robotronik/cdfr2019-1A/electronique/carte_principale_robot1A_cdF_2019/attribution_pattes_nucleo.pdf

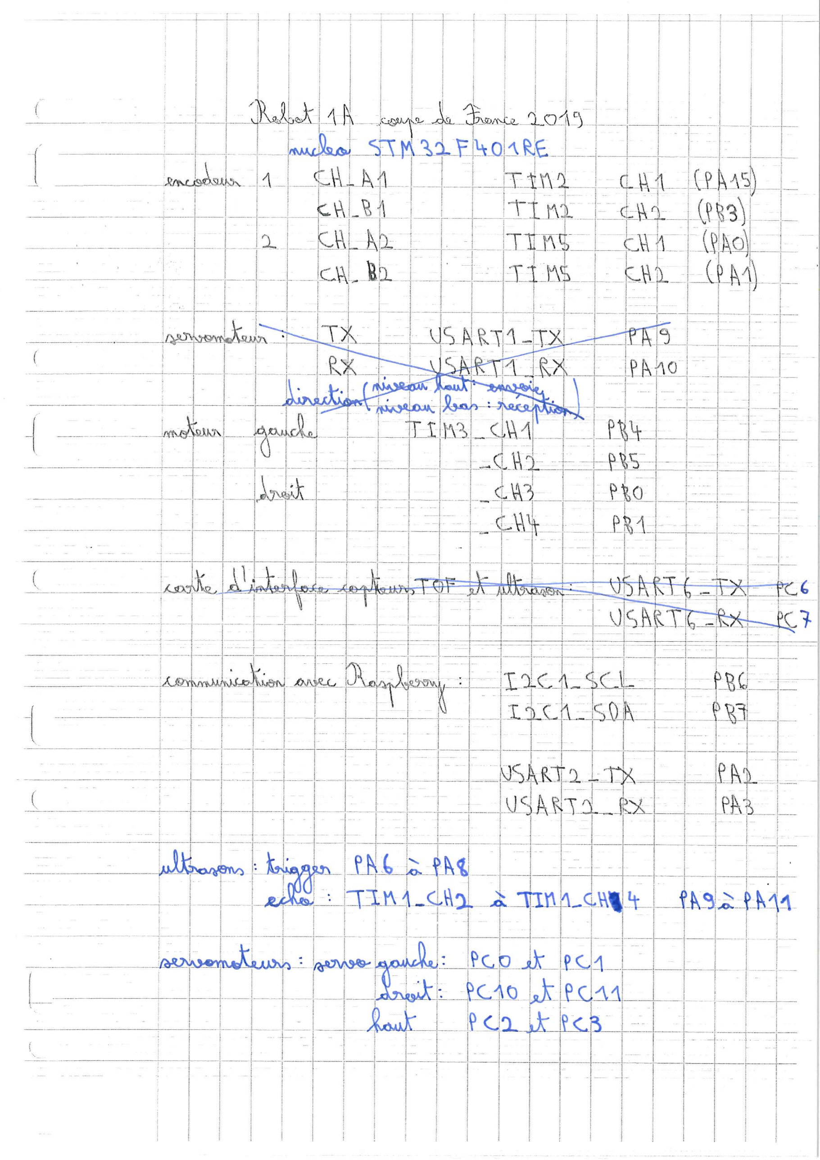
[picture p1: page 1]
