robotronik/cdfr2019-1A/electronique/carte_principale_robot1A_cdF_2019/carte_principale_robot1A_cdF2019.pdf

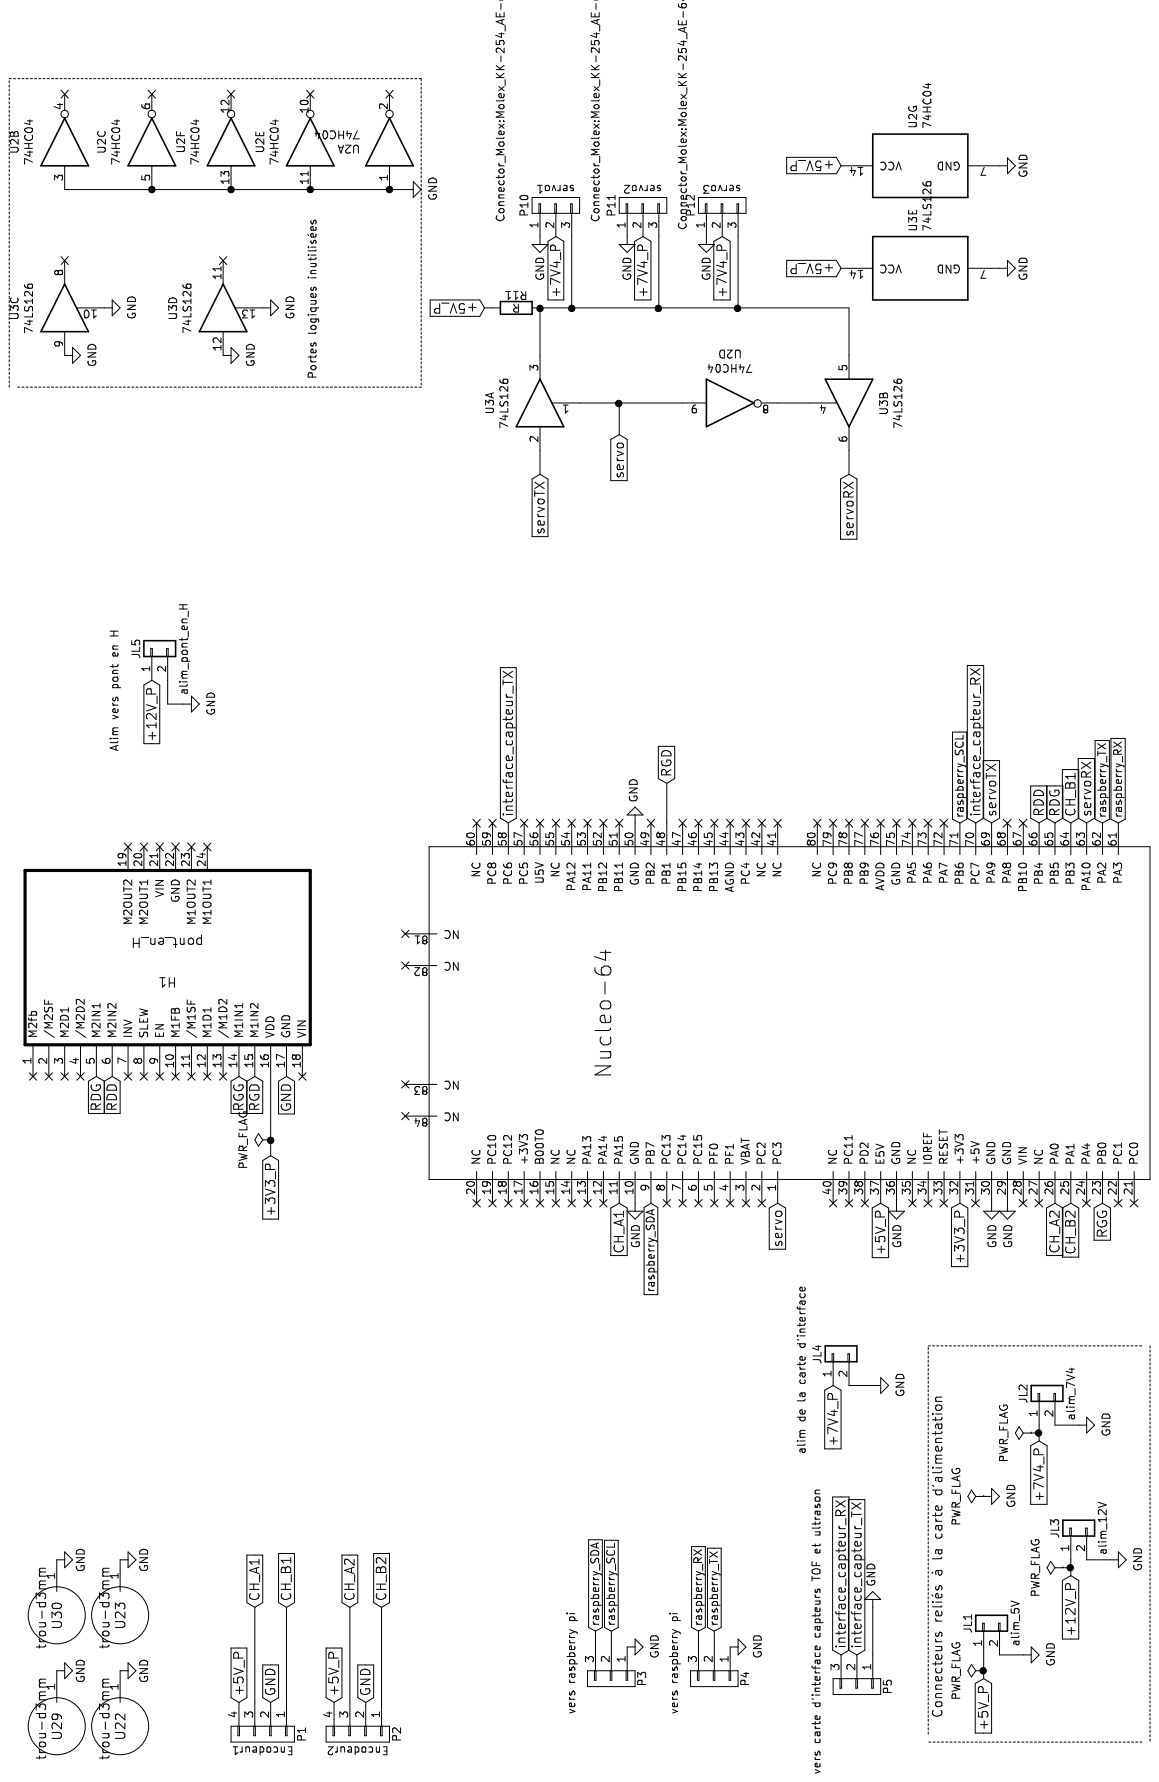
[picture p2: page 1]
