robotronik/cdfr2019-1A/electronique/carte_principale_robot1A_cdF_2019/carte_principale_robot1A_cdF2019.kicad_pcb

## KiCad design electronique/carte_principale_robot1A_cdF_2019/carte_principale_robot1A_cdF2019.kicad_pcb (2019-03-20)

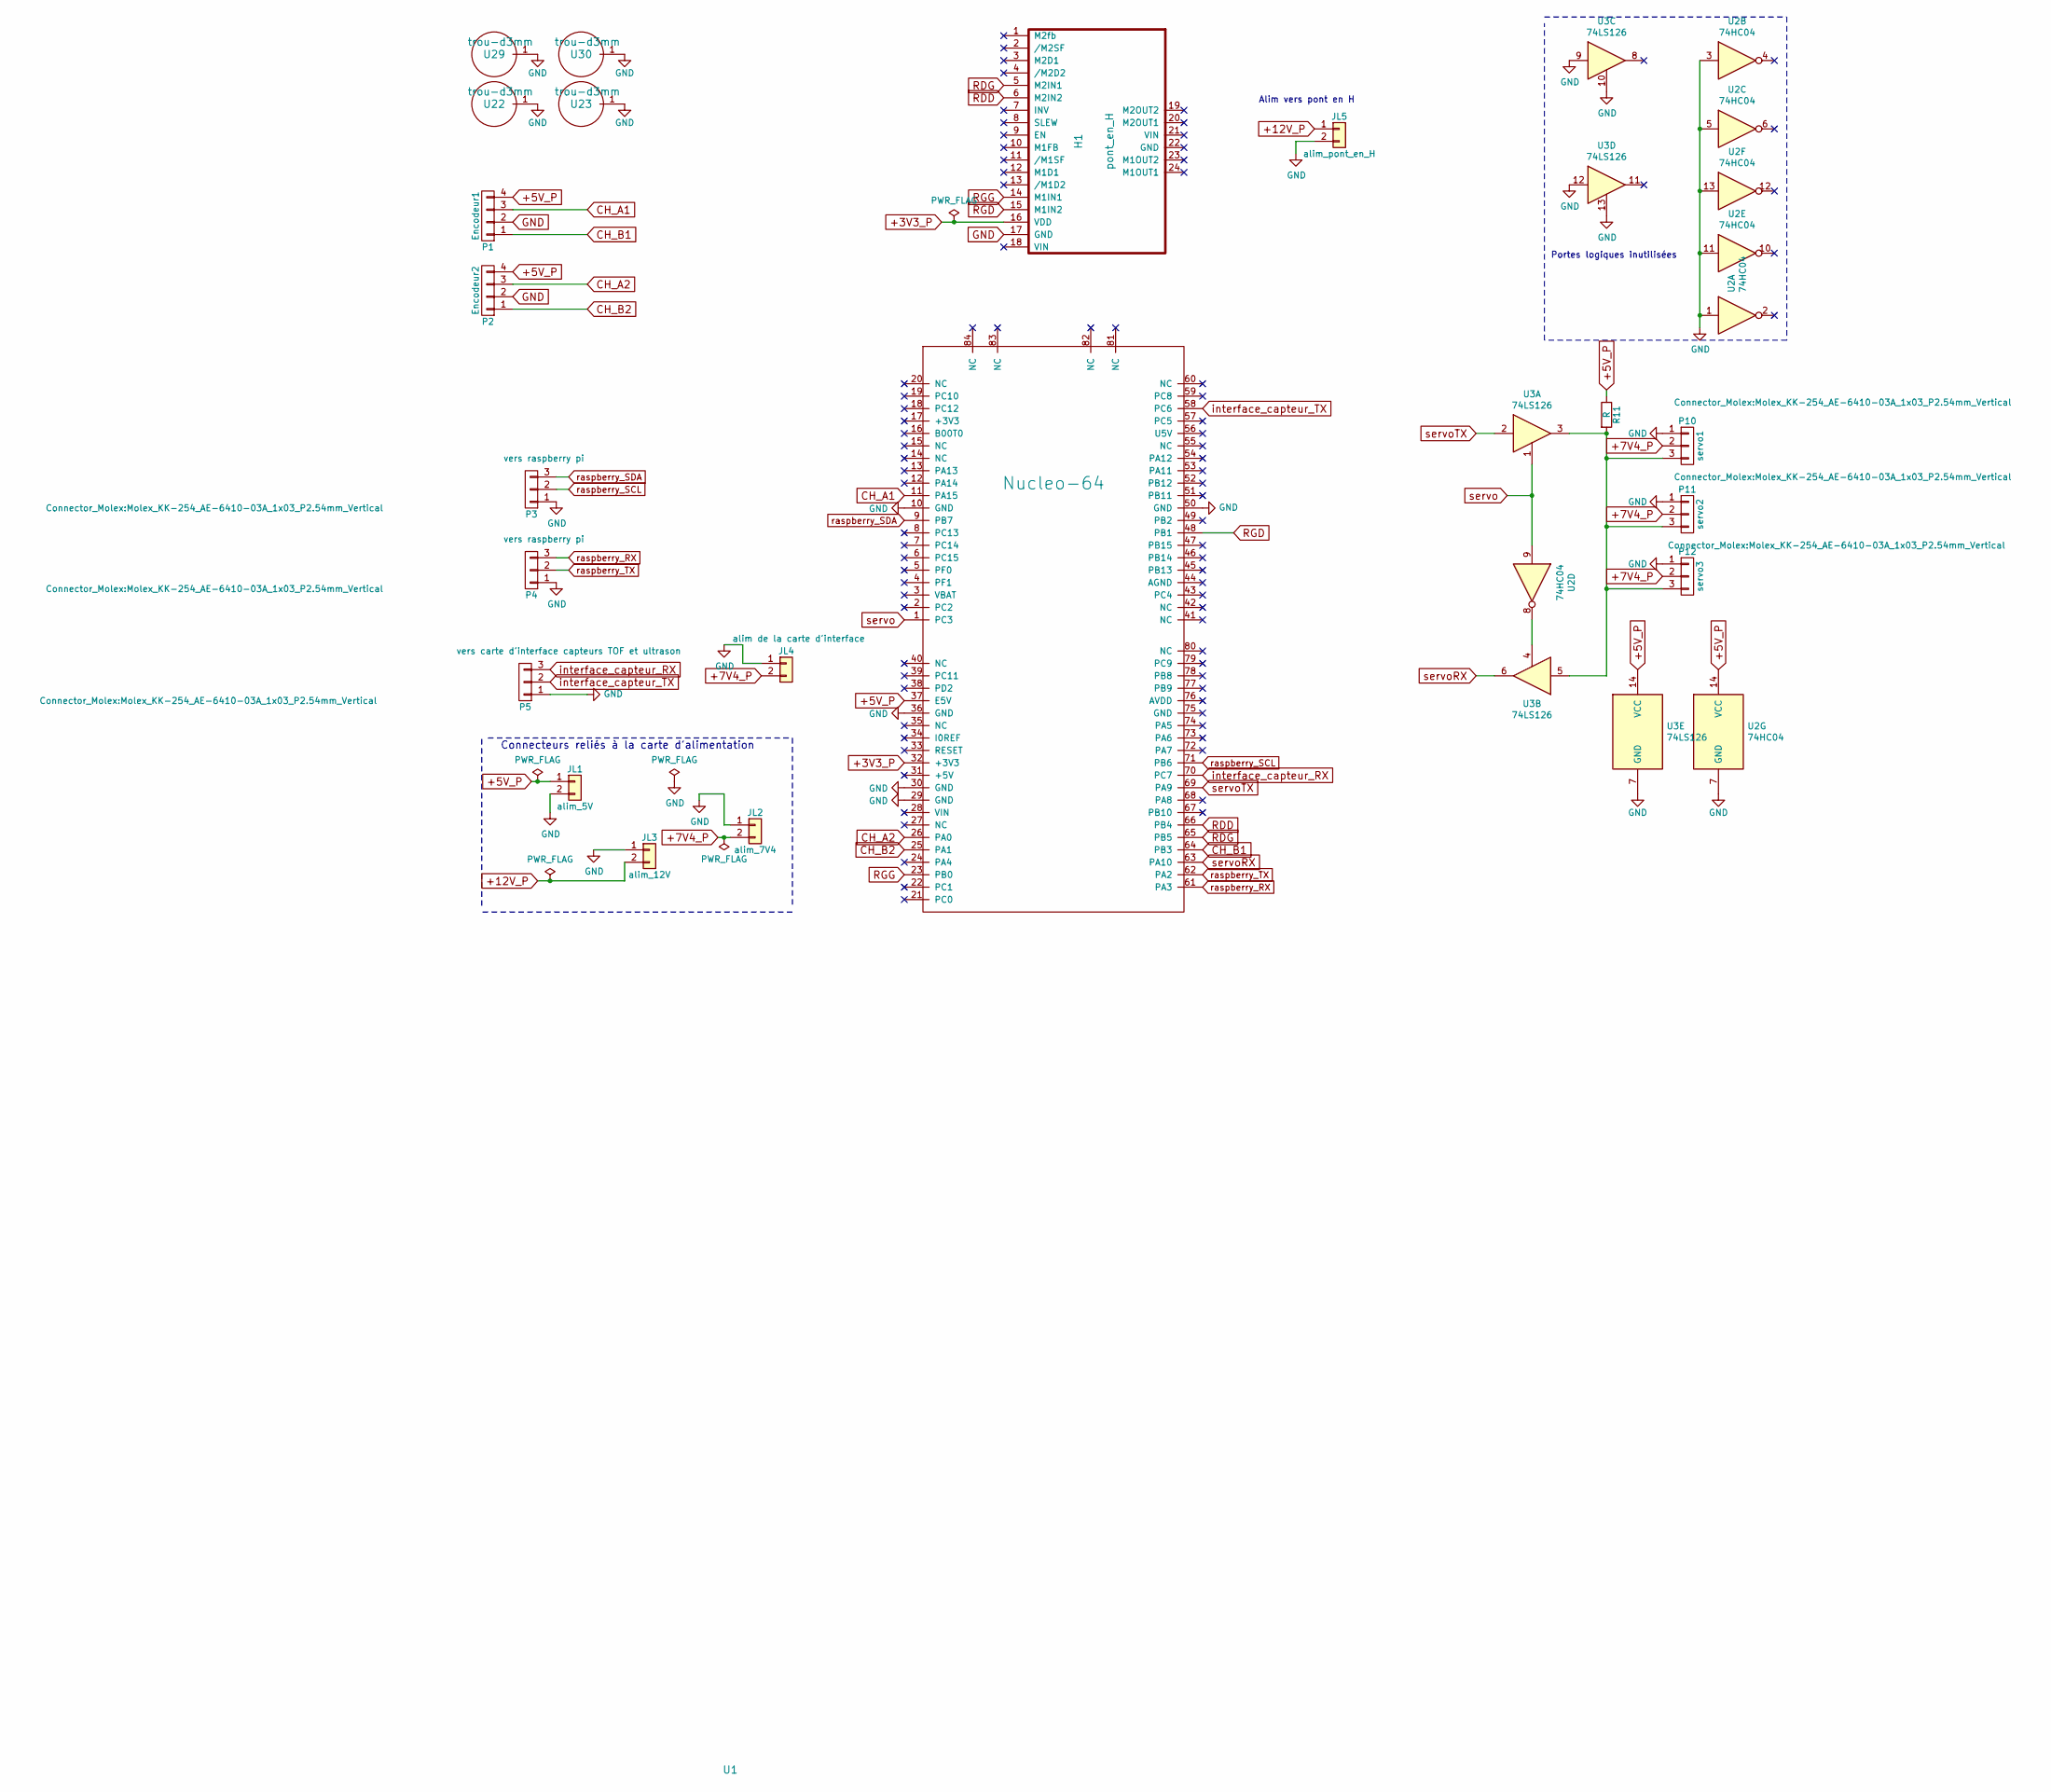
[picture p3: schematic carte_principale_robot1A_cdF2019.sch]

Parts:
H1: pont_en_H; MC33926-Pont en H
JL1: alim_5V; Molex_KK-254_AE-6410-02A_1x02_P2.54mm_Vertical
JL2: alim_7V4; B plug 5mm
JL3: alim_12V; B plug 5mm
JL4: alim de la carte d'interface; B plug 5mm
JL5: alim_pont_en_H; PinHeader_1x02_P2.54mm_Vertical
P1: Encodeur1; Molex_KK-254_AE-6410-04A_1x04_P2.54mm_Vertical
P2: Encodeur2; Molex_KK-254_AE-6410-04A_1x04_P2.54mm_Vertical
P3, P4: vers raspberry pi; Molex_KK-254_AE-6410-03A_1x03_P2.54mm_Vertical
P5: vers carte d'interface capteurs TOF et ultrason; Molex_KK-254_AE-6410-03A_1x03_P2.54mm_Vertical
P10: servo1; Molex_KK-254_AE-6410-03A_1x03_P2.54mm_Vertical
P11: servo2; Molex_KK-254_AE-6410-03A_1x03_P2.54mm_Vertical
P12: servo3; Molex_KK-254_AE-6410-03A_1x03_P2.54mm_Vertical
R11: R; R_1206_3216Metric
U1: Nucleo-64
U2: 74HC04; DIP-14_W7.62mm
U3: 74LS126; DIP-14_W7.62mm
U22, U23, U29, U30: trou-d3mm; trou_d3mm

Connections:
+3V3_P: H1.16 (VDD), U1.32 (+3V3)
+5V_P: JL1.1, P1.4, P2.4, R11.1, U1.37 (E5V), U2.14 (VCC), U3.14 (VCC)
+7V4_P: JL2.2, JL4.2, P10.2, P11.2, P12.2
+12V_P: JL3.2, JL5.1
CH_A1: P1.3, U1.11 (PA15)
CH_A2: P2.3, U1.26 (PA0)
CH_B1: P1.1, U1.64 (PB3)
CH_B2: P2.1, U1.25 (PA1)
GND: H1.17 (GND), JL1.2, JL2.1, JL3.1, JL4.1, JL5.2, P1.2, P2.2, P3.1, P4.1, P5.1, P10.1, P11.1, P12.1, U1.10 (GND), U1.29 (GND), U1.30 (GND), U1.36 (GND), U1.50 (GND), U2.1, U2.3, U2.5, U2.7 (GND), U2.11, U2.13, U3.7 (GND), U3.9, U3.10, U3.12, U3.13, U22.1, U23.1, U29.1, U30.1
unnamed: P10.3, P11.3, P12.3, R11.2, U3.3, U3.5
unnamed: U2.8, U3.4
RDD: H1.6 (M2IN2), U1.66 (PB4)
RDG: H1.5 (M2IN1), U1.65 (PB5)
RGD: H1.15 (M1IN2), U1.48 (PB1)
RGG: H1.14 (M1IN1), U1.23 (PB0)
interface_capteur_RX: P5.3, U1.70 (PC7)
interface_capteur_TX: P5.2, U1.58 (PC6)
raspberry_RX: P4.3, U1.61 (PA3)
raspberry_SCL: P3.2, U1.71 (PB6)
raspberry_SDA: P3.3, U1.9 (PB7)
raspberry_TX: P4.2, U1.62 (PA2)
servo: U1.1 (PC3), U2.9, U3.1
servoRX: U1.63 (PA10), U3.6
servoTX: U1.69 (PA9), U3.2

Notes on the sheet:
Connecteurs reliés à la carte d'alimentation
Alim vers pont en H
Portes logiques inutilisées

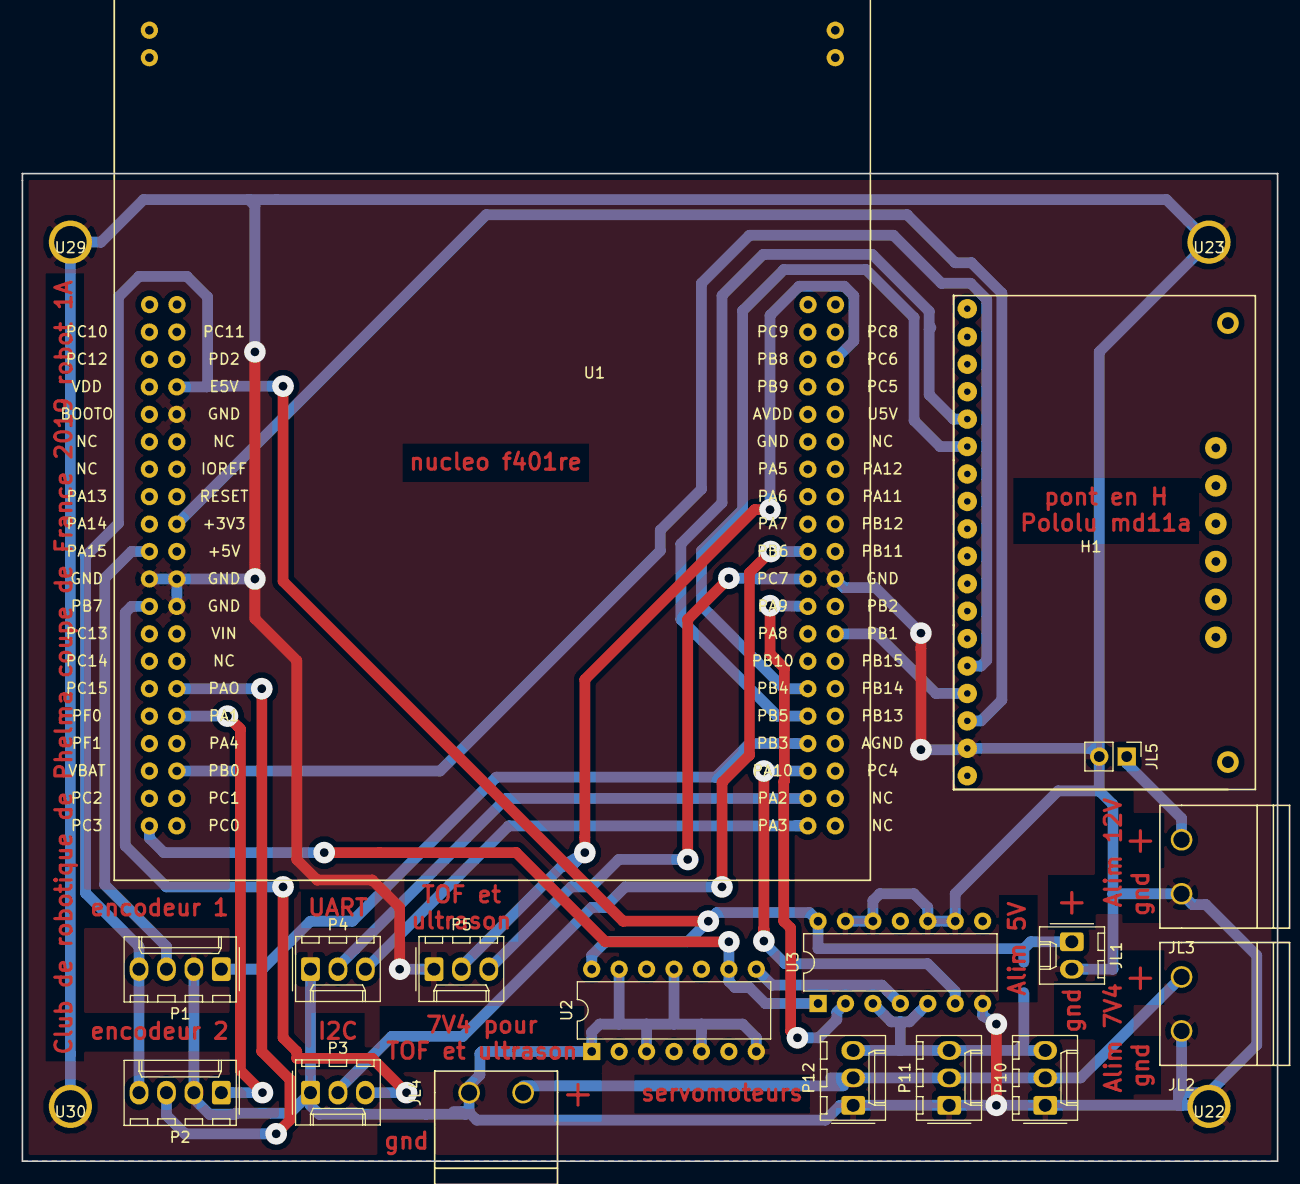
[picture p4: board carte_principale_robot1A_cdF2019.kicad_pcb from above]

Board: 2 copper layers, 116.2 x 91.4 mm, 22 parts (1 on the bottom side), 24 nets.
