robotronik/cdfr2019-1A/asservissement/Src/main.c

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

/* Includes ------------------------------------------------------------------*/
#include "main.h"
#include "tim.h"
#include "usart.h"
#include "gpio.h"
#include "encoder.h"
/* USER CODE BEGIN Includes */
#include "stm32f4xx_hal.h"

/* USER CODE END Includes */


void SystemClock_Config(void);
/**
  * @brief  The application entry point.
  * @retval int
  */
int main(void)
{
  /* MCU Configuration--------------------------------------------------------*/

  /* Reset of all peripherals, Initializes the Flash interface and the Systick. */
  HAL_Init();

  /* Configure the system clock */
  SystemClock_Config();

  /* Initialize all configured peripherals */
  MX_GPIO_Init();
  MX_TIM3_Init();
  MX_TIM2_Init();
  MX_USART2_Init();
  MX_TIM5_Init();
  /* USER CODE BEGIN 2 */
  HAL_TIM_Base_Start(&htim3);
  HAL_TIM_Base_Start(&htim5);
  HAL_TIM_Base_Start(&htim2);
  HAL_TIM_Base_Start_IT(&htim2);
  HAL_TIM_Base_Start_IT(&htim5);
	HAL_TIM_PWM_Start(& htim3, TIM_CHANNEL_1);
	HAL_TIM_PWM_Start(& htim3, TIM_CHANNEL_2);
  HAL_TIM_PWM_Start(& htim3, TIM_CHANNEL_3);
	HAL_TIM_PWM_Start(& htim3, TIM_CHANNEL_4);
  //distance_encoder=10;

/*
void navigation(asservissement* asserv,parametre* cstes){
    int i=0;
    (asserv->perreur)->x=255;
    (asserv->perreur)->y=255;
    
    *(asserv->pconsigne->gauche)=255;
    *(asserv->pconsigne->droite)=255;
    commande_moteur((asserv->pconsigne->gauche),(asserv->pconsigne->droite));
}
*/
  //void init(int nbpoint,int epsilon,Point* cap,int* ptheta,unsigned int* cnt_droite,
//  unsigned int* cnt_gauche,unsigned int* pdistanceparcourue_droite,unsigned int* pdistanceparcourue_gauche,int* px,int* py,int* moy_prev,int* pconsigne_gauche,int* pconsigne_droite);
  /* USER CODE END 2 */

  /* Infinite loop */
  /* USER CODE BEGIN WHILE */
  while (1)
  {
       // htim3.Instance->CCR1 = 160;
      //htim3.Instance->CCR2 = 0;
      //htim3.Instance->CCR3 = 130;
      //htim3.Instance->CCR4 = 0;
     /**pconsigne_droite=120;
     *pconsigne_gauche=120;
     commande_moteur(pconsigne_gauche,pconsigne_droite);*///commande des moteurs fonctionne
    *px=0;
    *py=0;
    consigne(0.1,200,0,px,py,pconsigne_gauche,pconsigne_droite,0);
    commande_moteur(pconsigne_gauche,pconsigne_droite);
    printf(" %ld \n",(&htim2)->Instance->CNT);
    printf(" %ld \n",(&htim5)->Instance->CNT);
    theta(ptheta,cnt_droite,cnt_gauche,distance_encoder);
    mise_a_jour_distance(pdistanceparcourue_droite,pdistanceparcourue_gauche);
    mise_a_jour_x_y(px,py,ptheta,moy_prev,pdistanceparcourue_droite,pdistanceparcourue_gauche);
    /*
   
    */
    ///*
    //commande_moteur((asserv->pconsigne->gauche),(asserv->pconsigne->droite));
    //*/
    //navigation(nbpoint,epsilon,cap,ptheta,cnt_droite, cnt_gauche, pdistanceparcourue_droite,pdistanceparcourue_gauche, px, py, moy_prev, pconsigne_gauche,pconsigne_droite);

    //    navigation(asserv,cstes);
  
   
/*
  int i=0;
  int erreur_x=255;
  int erreur_y=255;
  int objectif_x=20;
  int objectif_y=20;
/*  for(i=0;i<nbpoint;i++){
    objectif_x=(cap+i)->x;
    objectif_y=(cap+i)->y;
*/
  //  while(epsilon<erreur_x || epsilon<erreur_y){
//*//*
/*
      theta(ptheta,cnt_droite,cnt_gauche,distance_encoder);
      mise_a_jour_distance(pdistanceparcourue_droite,pdistanceparcourue_gauche);
      mise_a_jour_x_y(px,py,ptheta,moy_prev,pdistanceparcourue_droite,pdistanceparcourue_gauche);

      consigne(epsilon,objectif_x,objectif_y,px,py,pconsigne_gauche,pconsigne_droite,ptheta);
    
      //*pconsigne_gauche=120;
      //*pconsigne_droite=120;
     /* if (*px>0.001){*/
/*      commande_moteur(pconsigne_gauche,pconsigne_droite);
      erreur_x=*px-objectif_x;
      erreur_y=*py-objectif_y;
    /*}
    else{
      htim3.Instance->CCR1 = 0;
      htim3.Instance->CCR2 = 0;
      htim3.Instance->CCR3 = 0;
      htim3.Instance->CCR4 = 0;
    }}*/
    }
  }


  
    /* USER CODE END WHILE */

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
