robotronik/cdfr2019-1A/asservissement/asservissement.ioc

Mcu.UserName=STM32F401RETx
PA0-WKUP.Signal=S_TIM5_CH1
PA1.Signal=S_TIM5_CH2
PA14.Signal=SYS_JTCK-SWCLK
PA15.Signal=S_TIM2_CH1_ETR
PA2.Signal=USART2_TX
PA3.Signal=USART2_RX
PA4.Signal=USART2_CK
PB0.Signal=S_TIM3_CH3
PB1.Signal=S_TIM3_CH4
PB3.Signal=S_TIM2_CH2
PB4.Signal=S_TIM3_CH1
PB5.Signal=S_TIM3_CH2
