robotronik/cdfr2019-1A/asservissement/Inc/vincent.h

#ifndef __ENCODER_H_
#define __ENCODER_H_

#include "stm32f4xx_hal.h"

#define ENCODER_MAX 1440

//TEST ENCODER
#define TEST_ENCODER 0
#if TEST_ENCODER != 0
extern uint8_t led_level;
#if TEST_ENCODER != 1 && TEST_ENCODER != 2
#error "TEST_ENCODER MUST EQUALS 1 OR 2"
#endif
#warning "PROGRAM IS IN TEST_ENCODER MODE"
#endif

typedef enum Encoder_Dir_E{
  FORWARD, BACKWARD
}Encoder_Dir;

typedef struct Encoder_S{
  //Position (angle)
  volatile int last_pos;

  //Nombre de pas
  volatile int steps;

  //Timers
  // replace par le timer gitan de vincecent
  TIM_HandleTypeDef *htim;
  //volatile int cmpt;
  //TIM_HandleTypeDef *htima;  //jai ajouté ce truc pour gerer le fait quon a les channel repartis sur 4 truc différents
  
}Encoder;

Encoder* encoder_droit;
Encoder* encoder_gauche;

void init_encoder(Encoder *encoder,  TIM_HandleTypeDef *htima);
/**
 * Initialise encoder.
 */

int update_encoder(Encoder *encoder);

void start_encoder(Encoder *encoder);

#endif
