robotronik/cdfr2019-1A/(commit log)

2019-03-20 La carte principale telle qu'elle a été imprimée
    [carte_principale_robot1A_cdF2019.kicad_pcb, carte_principale_robot1A_cdF2019.sch]
2019-03-20 Utile pour la programmation de la carte Nucleo
2019-05-21 les codes de victor pour les 1A
