robotronik/cdfr2019-1A/(notices)

Notices in the files:
asservissement/Src/main.c:
COPYRIGHT(c) 2019 STMicroelectronics
(C) COPYRIGHT STMicroelectronics *****END OF FILE
